sufst/tsal/hardware/hv_sense/hv_sense.kicad_pcb

## KiCad design hardware/hv_sense/hv_sense.kicad_pcb (2022-02-28)

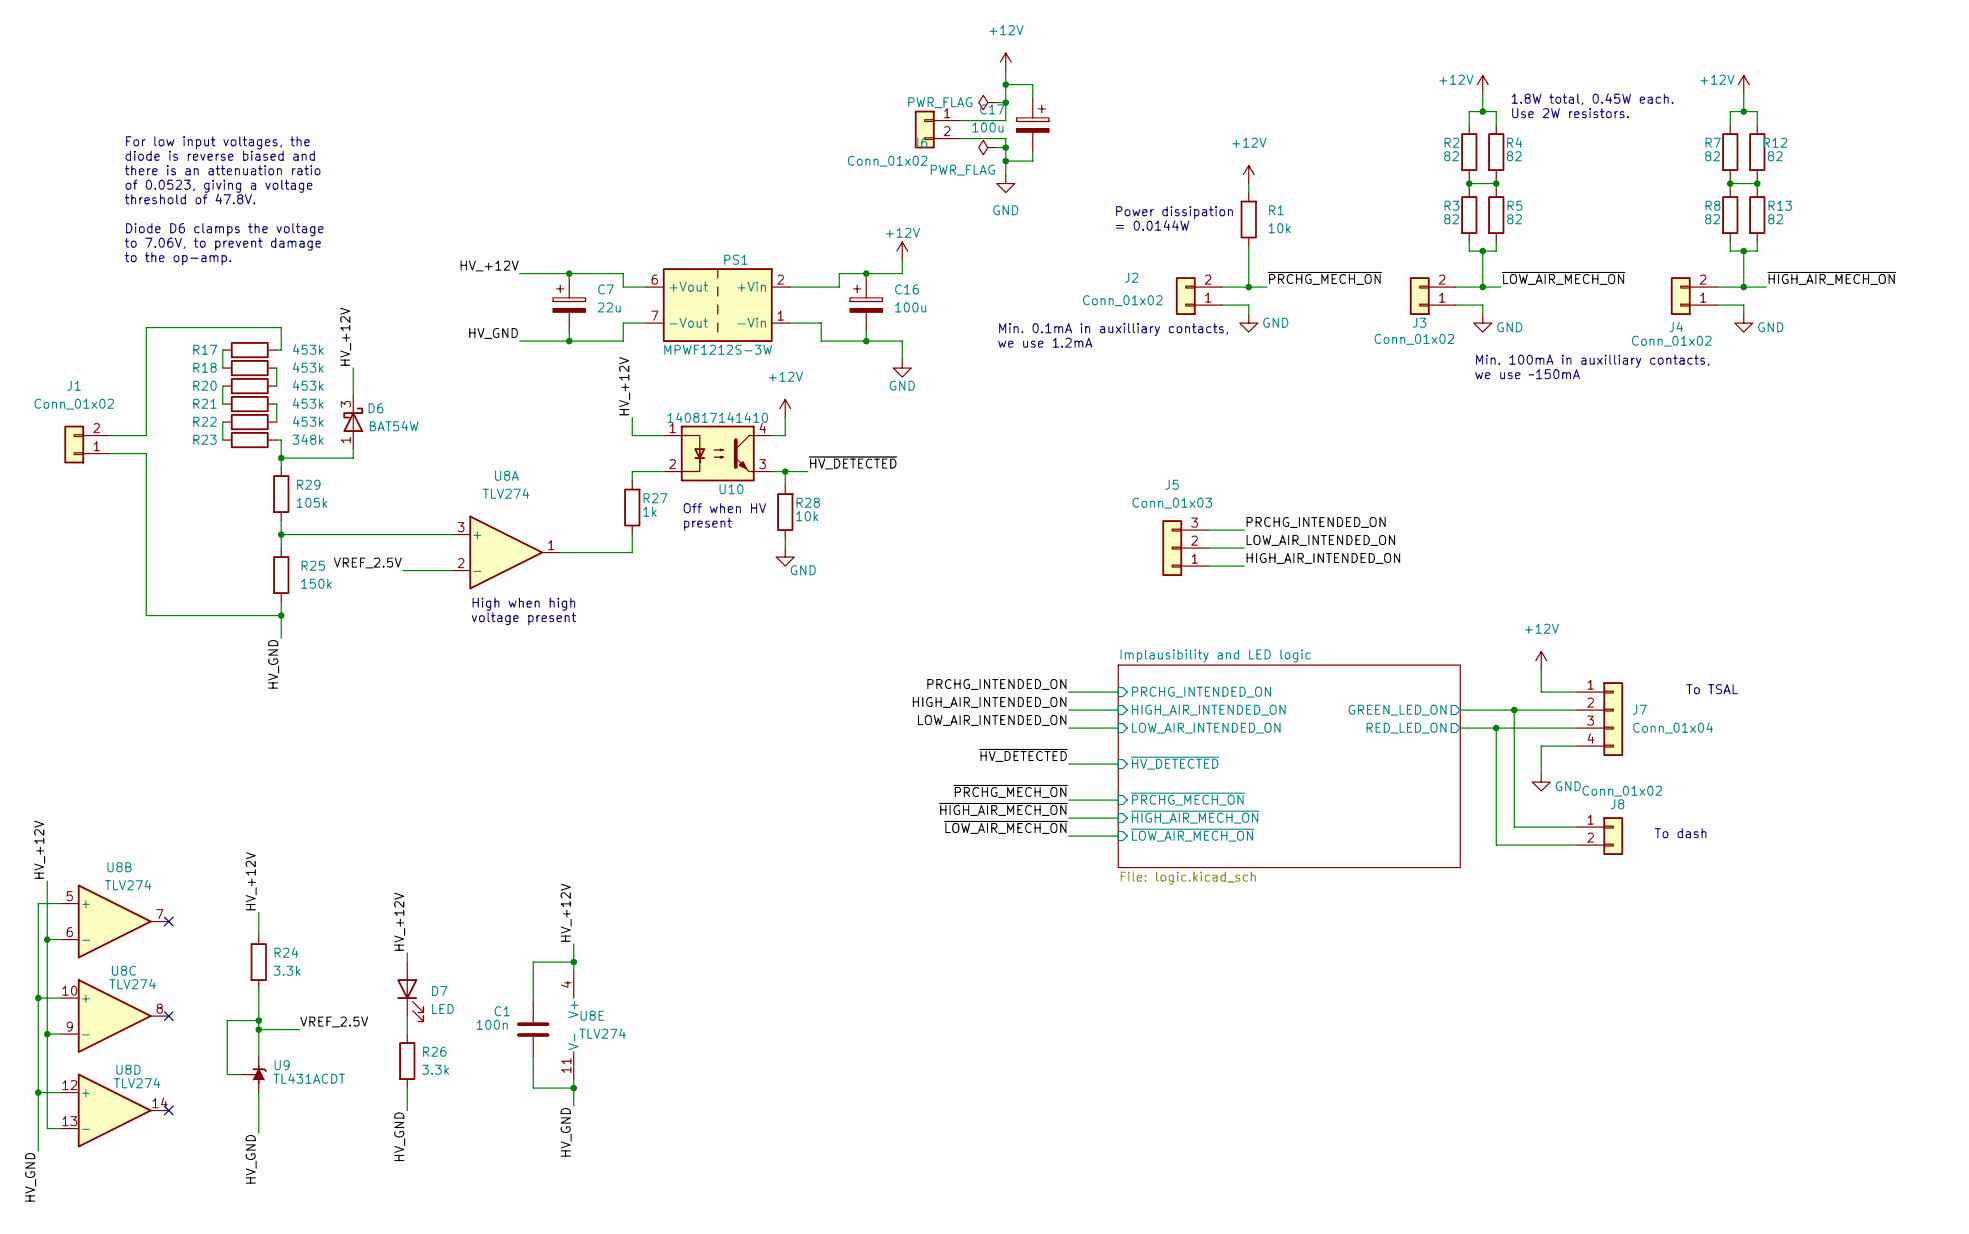
[picture p1: schematic hv_sense.kicad_sch]

Parts:
C1: 100n; C_0603_1608Metric
C7: 22u; CP_Radial_D8.0mm_P3.50mm
C16, C17: 100u; CP_Radial_D6.3mm_P2.50mm
D6: BAT54W; SOT-323_SC-70
D7: LED; LED_0603_1608Metric
J1, J2, J3, J4, J6, J8: Conn_01x02; Molex_Micro-Fit_3.0_43650-0200_1x02_P3.00mm_Horizontal
J5: Conn_01x03; Molex_Micro-Fit_3.0_43650-0300_1x03_P3.00mm_Horizontal
J7: Conn_01x04; Molex_Micro-Fit_3.0_43650-0400_1x04_P3.00mm_Horizontal
PS1: MPWF1212S-3W
R1, R28: 10k; R_0603_1608Metric
R2, R3, R4, R5, R7, R8, R12, R13: 82; R_2512_6332Metric
R17, R18, R20, R21, R22: 453k; R_0805_2012Metric
R23: 348k; R_0805_2012Metric
R24, R26: 3.3k; R_0603_1608Metric
R25: 150k; R_0603_1608Metric
R27: 1k; R_1206_3216Metric
R29: 105k; R_0805_2012Metric
U8: TLV274; SOIC-14_3.9x8.7mm_P1.27mm
U9: TL431ACDT; SOIC-8_3.9x4.9mm_P1.27mm
U10: 140817141410; DIP-4_W7.62mm

Connections:
+12V: C16.1, C17.1, J6.1, J7.1, PS1.2 (+Vin), R1.2, R2.1, R4.1, R7.1, R12.1, U10.4; also elsewhere on the board
/HIGH_AIR_INTENDED_ON: J5.1; also elsewhere on the board
/HV_+12V: C1.1, C7.1, D6.3 (K), D7.2 (A), PS1.6 (+Vout), R24.1, U8.4 (V+), U8.6 (-), U8.9 (-), U8.13 (-), U10.1
/HV_GND: C1.2, C7.2, J1.1, PS1.7 (-Vout), R25.2, R26.2, U8.5 (+), U8.10 (+), U8.11 (V-), U8.12 (+), U9.2 (A), U9.3 (A), U9.6 (A), U9.7 (A)
/Implausibility and LED logic/GREEN_LED_ON: J7.2, J8.1; also elsewhere on the board
/Implausibility and LED logic/RED_LED_ON: J7.3, J8.2; also elsewhere on the board
/LOW_AIR_INTENDED_ON: J5.2; also elsewhere on the board
/PRCHG_INTENDED_ON: J5.3; also elsewhere on the board
/VREF_2.5V: R24.2, U8.2 (-), U9.1 (K), U9.8 (REF)
/~HIGH_AIR_MECH_ON: J4.2, R8.2, R13.2; also elsewhere on the board
/~HV_DETECTED: R28.2, U10.3; also elsewhere on the board
/~LOW_AIR_MECH_ON: J3.2, R3.2, R5.2; also elsewhere on the board
/~PRCHG_MECH_ON: J2.2, R1.1; also elsewhere on the board
GND: C16.2, C17.2, J2.1, J3.1, J4.1, J6.2, J7.4, PS1.1 (-Vin), R28.1; also elsewhere on the board
unnamed: D6.1 (A), R23.1, R29.1
unnamed: D7.1 (K), R26.1
unnamed: J1.2, R17.1
unnamed: R2.2, R3.1, R4.2, R5.1
unnamed: R7.2, R8.1, R12.2, R13.1
unnamed: R17.2, R18.2
unnamed: R18.1, R20.1
unnamed: R20.2, R21.2
unnamed: R21.1, R22.1
unnamed: R22.2, R23.2
unnamed: R25.1, R29.2, U8.3 (+)
unnamed: R27.1, U8.1
unnamed: R27.2, U10.2

Notes on the sheet:
1.8W total, 0.45W each. Use 2W resistors.
Off when HV present
Power dissipation = 0.0144W
Min. 0.1mA in auxilliary contacts, we use 1.2mA
To TSAL
High when high voltage present
Min. 100mA in auxilliary contacts, we use ~150mA
For low input voltages, the diode is reverse biased and there is an attenuation ratio of 0.0523, giving a voltage threshold of 47.8V. Diode D6 clamps the voltage to 7.06V, to prevent damage to the op-amp.
To dash

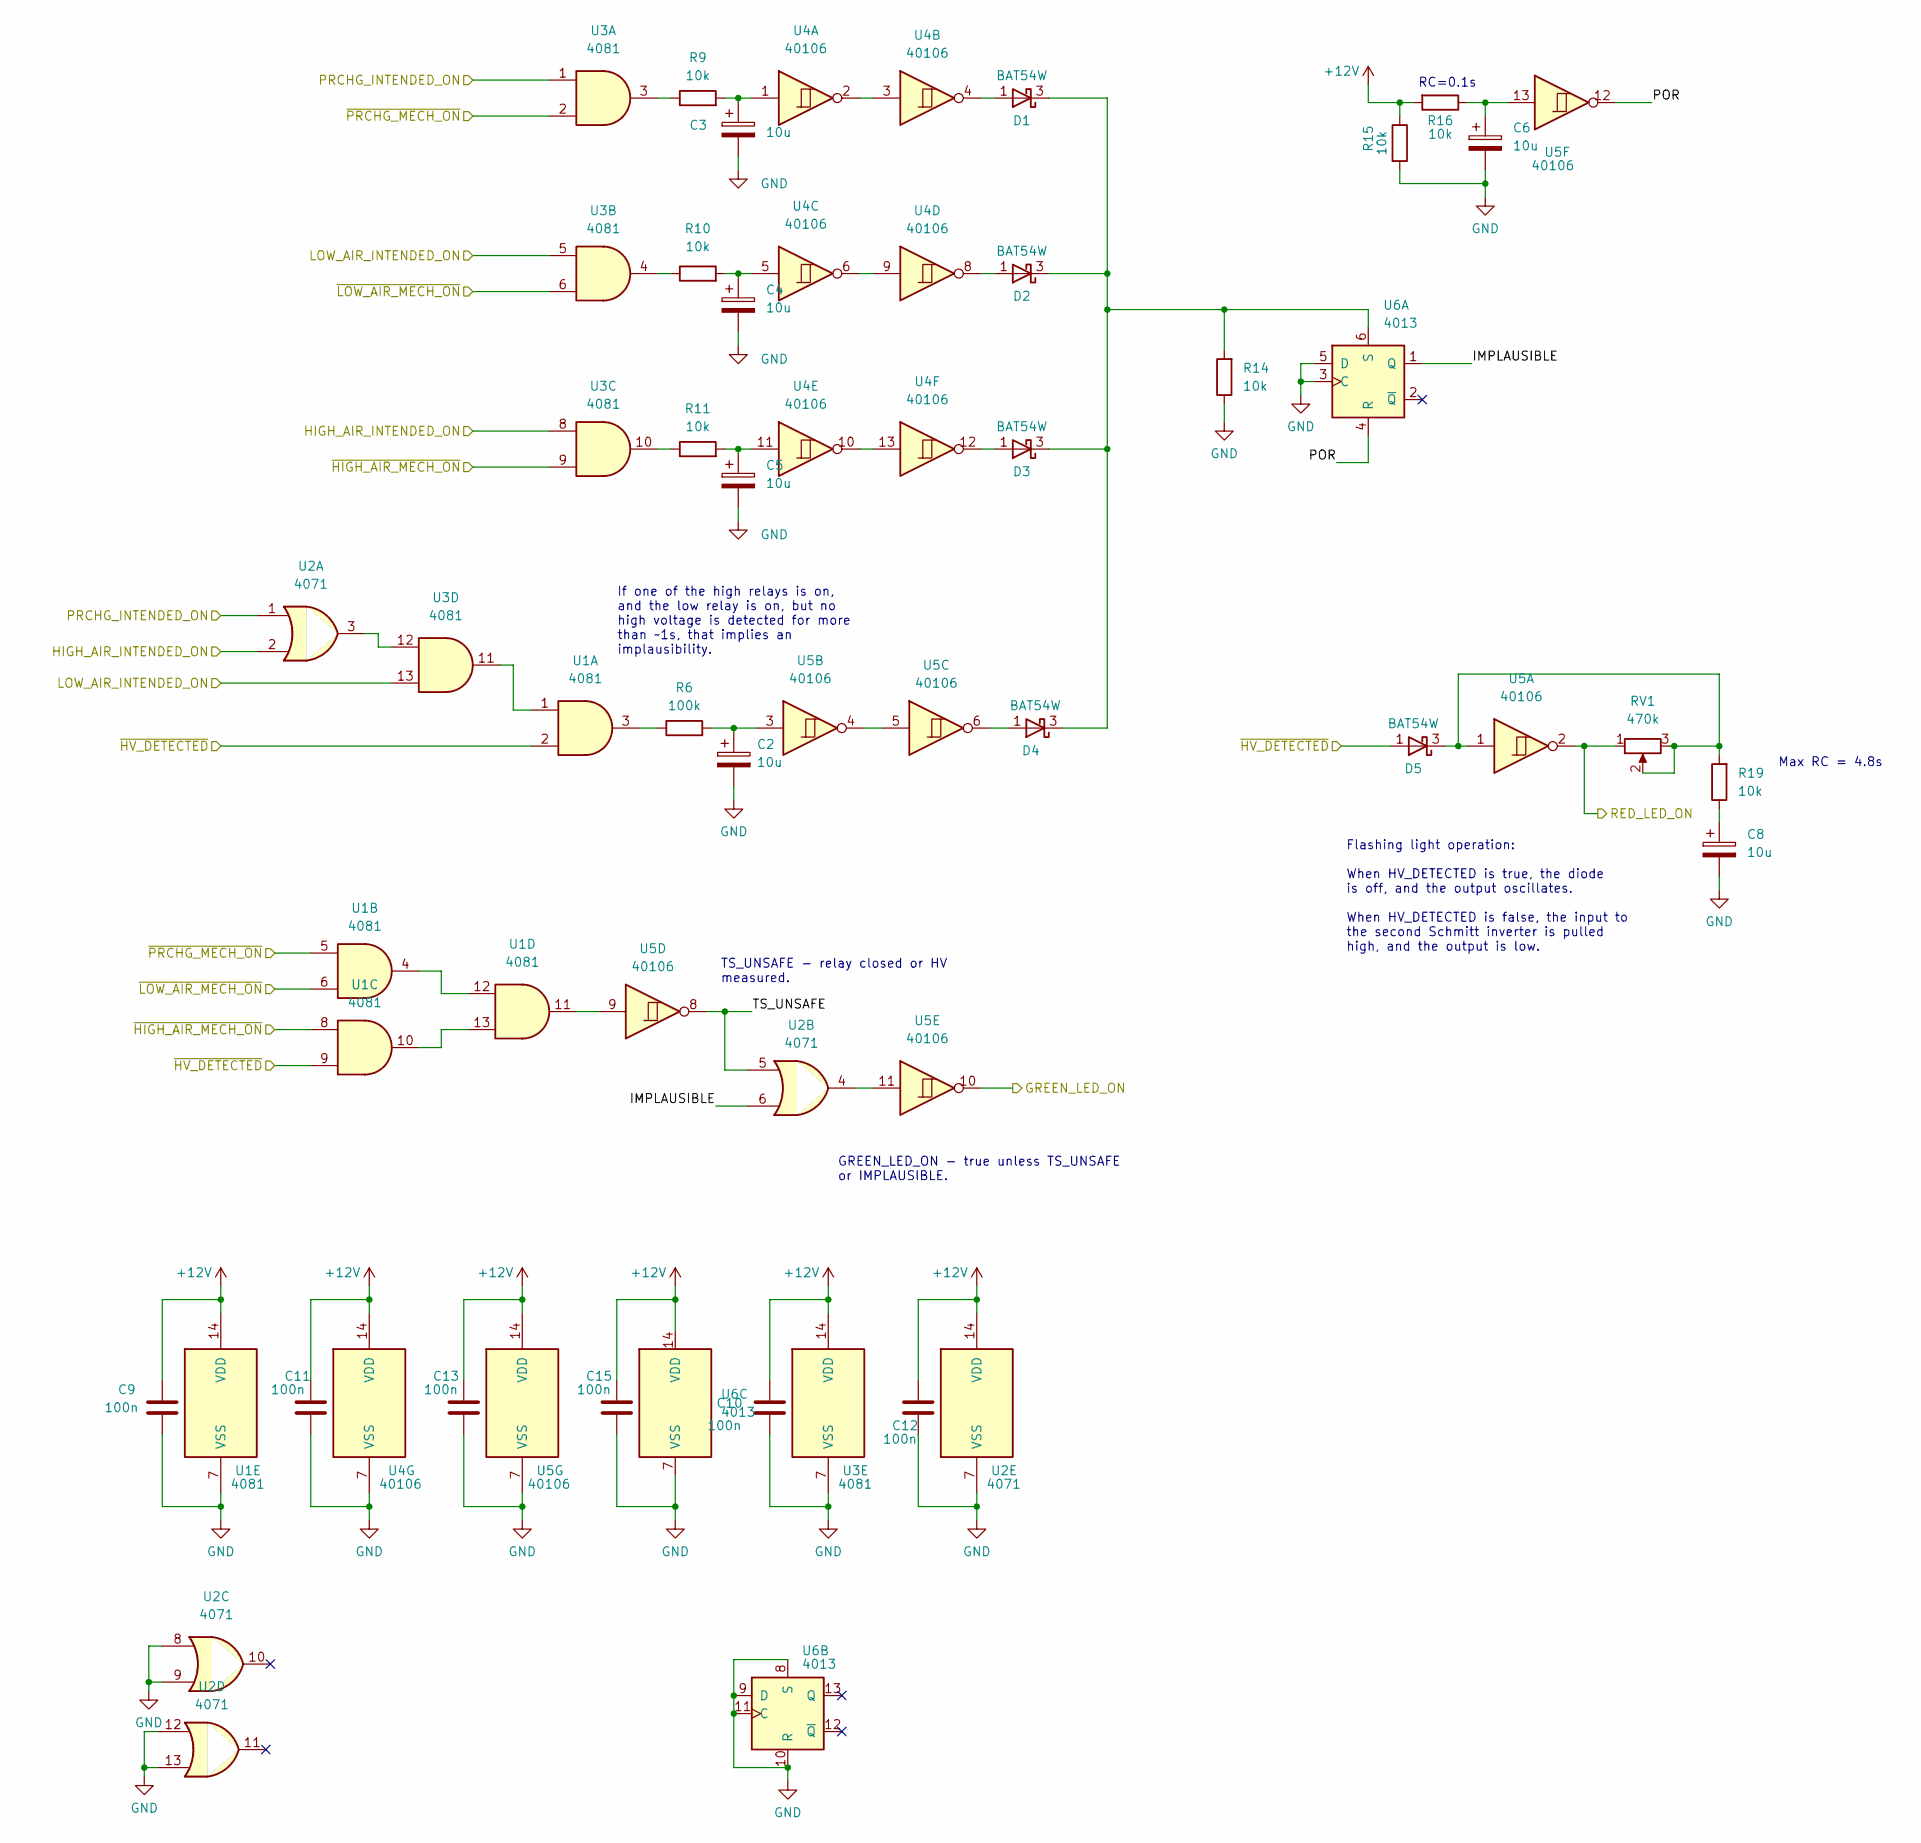
[picture p2: schematic logic.kicad_sch]

Parts:
C2, C3, C4, C5, C6, C8: 10u; CP_Radial_D5.0mm_P2.00mm
C9, C10, C11, C12, C13, C15: 100n; C_0603_1608Metric
D1, D2, D3, D4, D5: BAT54W; SOT-323_SC-70
R6: 100k; R_0603_1608Metric
R9, R10, R11, R14, R15, R16, R19: 10k; R_0603_1608Metric
RV1: 470k; Potentiometer_Bourns_3296W_Vertical
U1, U3: 4081; SOIC-14_3.9x8.7mm_P1.27mm
U2: 4071; SOIC-14_3.9x8.7mm_P1.27mm
U4, U5: 40106; SOIC-14_3.9x8.7mm_P1.27mm
U6: 4013; SOIC-14_3.9x8.7mm_P1.27mm

Connections:
+12V: C9.1, C10.1, C11.1, C12.1, C13.1, C15.1, R15.1, R16.2, U1.14 (VDD), U2.14 (VDD), U3.14 (VDD), U4.14 (VDD), U5.14 (VDD), U6.14 (VDD); also elsewhere on the board
/HIGH_AIR_INTENDED_ON: U2.2, U3.8; also elsewhere on the board
/Implausibility and LED logic/GREEN_LED_ON: U5.10; also elsewhere on the board
/Implausibility and LED logic/IMPLAUSIBLE: U2.6, U6.1 (Q)
/Implausibility and LED logic/POR: U5.12, U6.4 (R)
/Implausibility and LED logic/RED_LED_ON: RV1.1, U5.2; also elsewhere on the board
/Implausibility and LED logic/TS_UNSAFE: U2.5, U5.8
/LOW_AIR_INTENDED_ON: U3.5, U3.13; also elsewhere on the board
/PRCHG_INTENDED_ON: U2.1, U3.1; also elsewhere on the board
/~HIGH_AIR_MECH_ON: U1.8, U3.9; also elsewhere on the board
/~HV_DETECTED: D5.1 (A), U1.2, U1.9; also elsewhere on the board
/~LOW_AIR_MECH_ON: U1.6, U3.6; also elsewhere on the board
/~PRCHG_MECH_ON: U1.5, U3.2; also elsewhere on the board
GND: C2.2, C3.2, C4.2, C5.2, C6.2, C8.2, C9.2, C10.2, C11.2, C12.2, C13.2, C15.2, R14.1, R15.2, U1.7 (VSS), U2.7 (VSS), U2.8, U2.9, U2.12, U2.13, U3.7 (VSS), U4.7 (VSS), U5.7 (VSS), U6.3 (C), U6.5 (D), U6.7 (VSS), U6.8 (S), U6.9 (D), U6.10 (R), U6.11 (C); also elsewhere on the board
unnamed: C2.1, R6.2, U5.3
unnamed: C3.1, R9.2, U4.1
unnamed: C4.1, R10.2, U4.5
unnamed: C5.1, R11.2, U4.11
unnamed: C6.1, R16.1, U5.13
unnamed: C8.1, R19.1
unnamed: D1.1 (A), U4.4
unnamed: D1.3 (K), D2.3 (K), D3.3 (K), D4.3 (K), R14.2, U6.6 (S)
unnamed: D2.1 (A), U4.8
unnamed: D3.1 (A), U4.12
unnamed: D4.1 (A), U5.6
unnamed: D5.3 (K), R19.2, RV1.2, RV1.3, U5.1
unnamed: R6.1, U1.3
unnamed: R9.1, U3.3
unnamed: R10.1, U3.4
unnamed: R11.1, U3.10
unnamed: U1.1, U3.11
unnamed: U1.10, U1.13
unnamed: U1.11, U5.9
unnamed: U1.4, U1.12
unnamed: U2.3, U3.12
unnamed: U2.4, U5.11
unnamed: U4.2, U4.3
unnamed: U4.6, U4.9
unnamed: U4.10, U4.13
unnamed: U5.4, U5.5

Notes on the sheet:
Flashing light operation: When HV_DETECTED is true, the diode is off, and the output oscillates. When HV_DETECTED is false, the input to the second Schmitt inverter is pulled high, and the output is low.
Max RC = 4.8s
GREEN_LED_ON - true unless TS_UNSAFE or IMPLAUSIBLE.
If one of the high relays is on, and the low relay is on, but no high voltage is detected for more than ~1s, that implies an implausibility.
RC=0.1s
TS_UNSAFE - relay closed or HV measured.

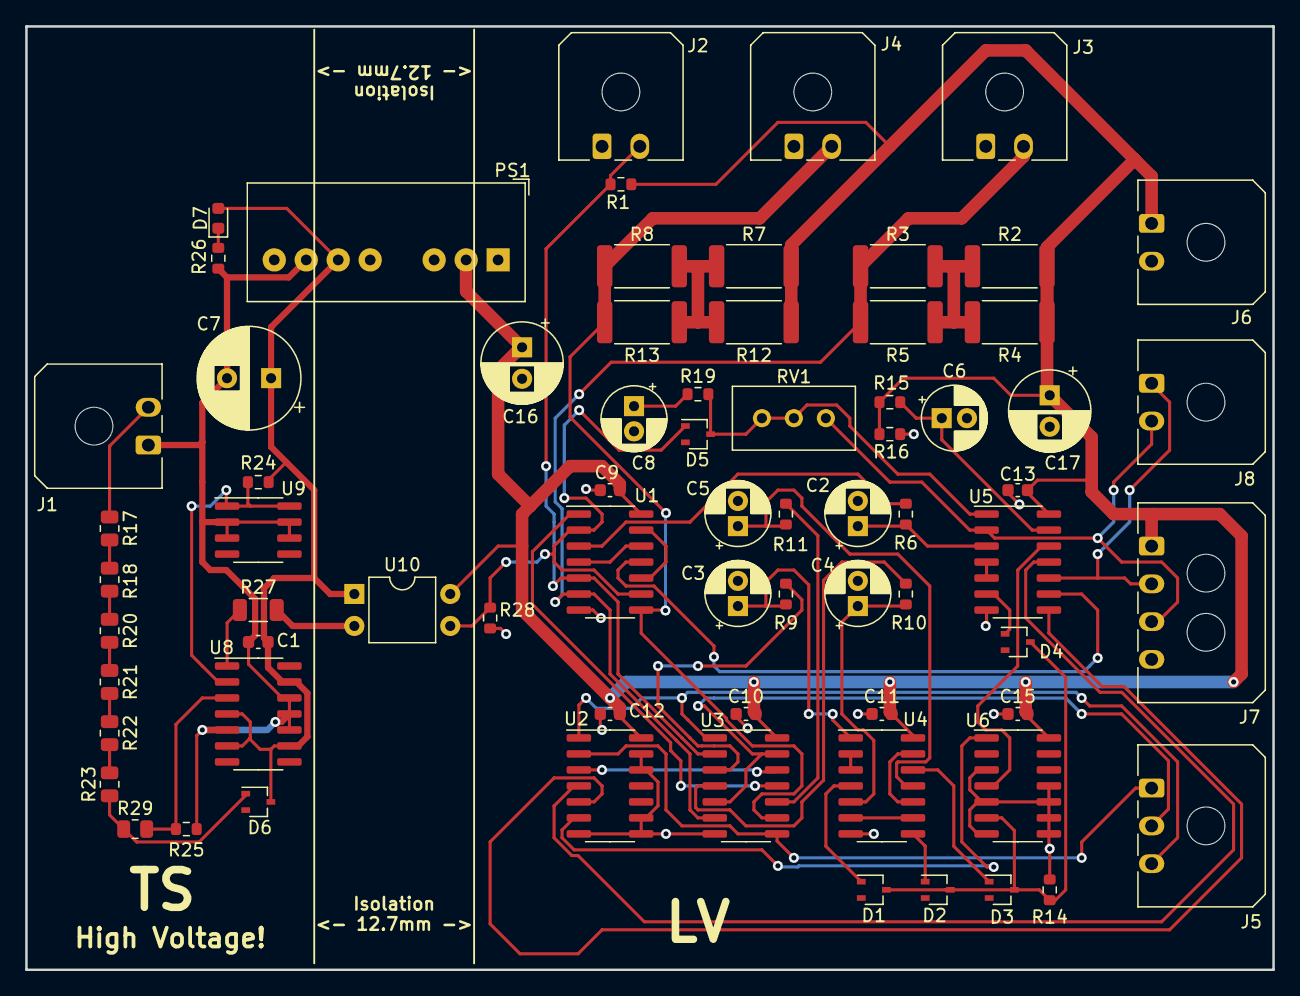
[picture p3: board hv_sense.kicad_pcb from above]

Board: 2 copper layers, 99.1 x 74.9 mm, 71 parts (0 on the bottom side), 56 nets.
