sufst/tsal/hardware/tsal/tsal.kicad_pcb

## KiCad design hardware/tsal/tsal.kicad_pcb (2022-02-18)

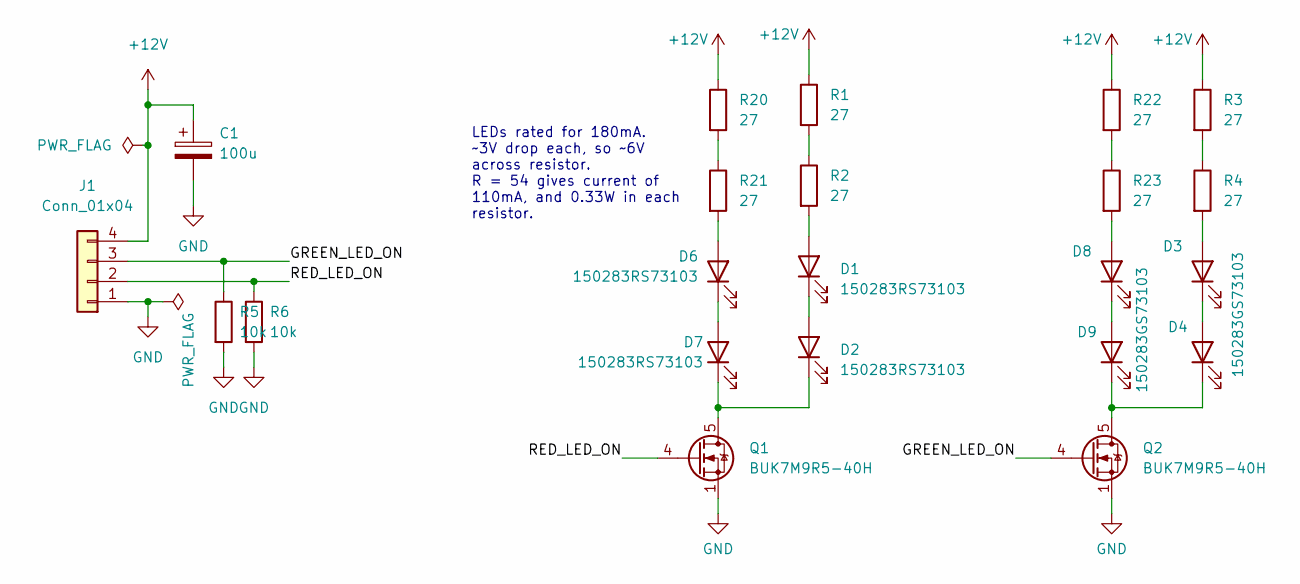
[picture p4: schematic tsal.kicad_sch]

Parts:
C1: 100u; CP_Radial_D6.3mm_P2.50mm
D1, D2, D6, D7: 150283RS73103; Wurth_WL-SMTW
D3, D4, D8, D9: 150283GS73103; Wurth_WL-SMTW
J1: Conn_01x04; Molex_Micro-Fit_3.0_43650-0400_1x04_P3.00mm_Horizontal
Q1, Q2: BUK7M9R5-40H; LFPAK33
R1, R2, R3, R4, R20, R21, R22, R23: 27; R_2512_6332Metric
R5, R6: 10k; R_0603_1608Metric

Connections:
+12V: C1.1, J1.4, R1.1, R3.1, R20.1, R22.1
/GREEN_LED_ON: J1.3, Q2.4 (G), R5.1
/RED_LED_ON: J1.2, Q1.4 (G), R6.1
GND: C1.2, J1.1, Q1.1 (S), Q1.2 (S), Q1.3 (S), Q2.1 (S), Q2.2 (S), Q2.3 (S), R5.2, R6.2
unnamed: D1.1 (K), D2.2 (A)
unnamed: D1.2 (A), R2.2
unnamed: D3.1 (K), D4.2 (A)
unnamed: D3.2 (A), R4.2
unnamed: D6.1 (K), D7.2 (A)
unnamed: D6.2 (A), R21.2
unnamed: D2.1 (K), D7.1 (K), Q1.5 (D)
unnamed: D8.1 (K), D9.2 (A)
unnamed: D8.2 (A), R23.2
unnamed: D4.1 (K), D9.1 (K), Q2.5 (D)
unnamed: R1.2, R2.1
unnamed: R3.2, R4.1
unnamed: R20.2, R21.1
unnamed: R22.2, R23.1

Notes on the sheet:
LEDs rated for 180mA. ~3V drop each, so ~6V across resistor. R = 54 gives current of 110mA, and 0.33W in each resistor.

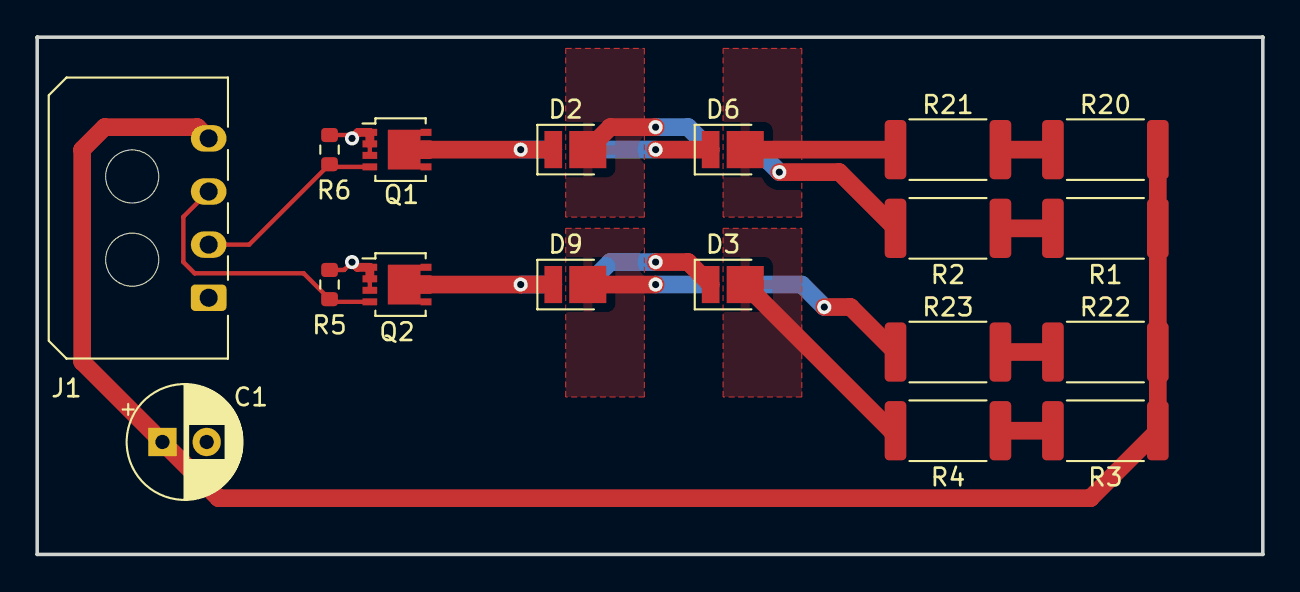
[picture p5: board tsal.kicad_pcb from above]

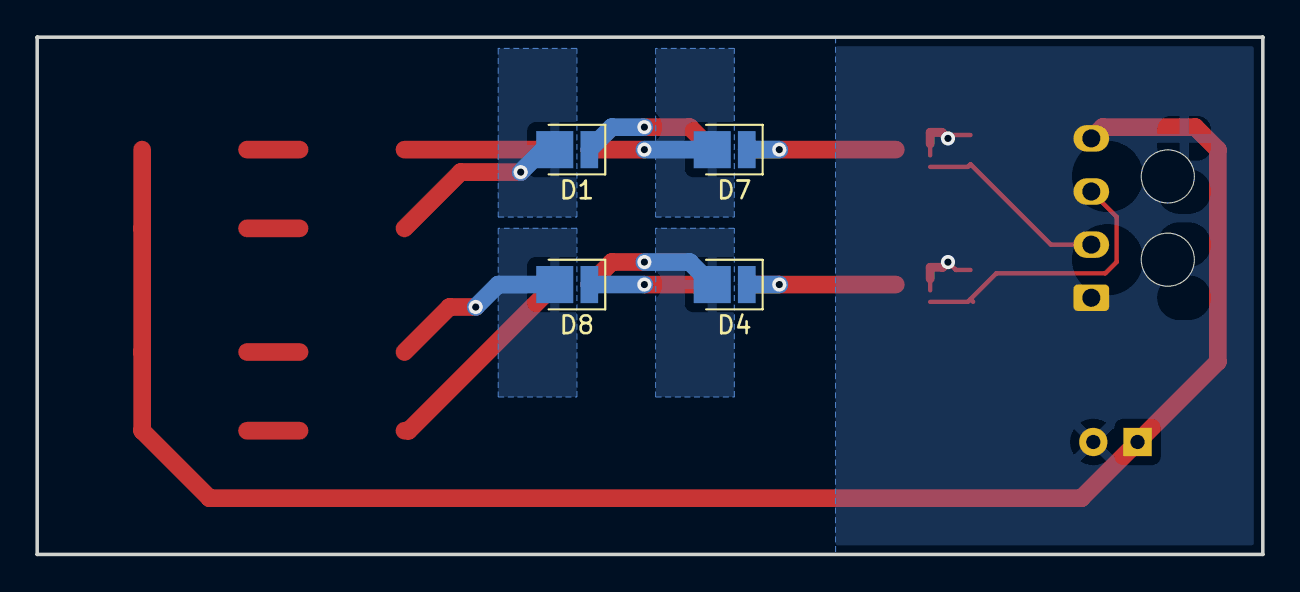
[picture p6: board tsal.kicad_pcb from below]

Board: 2 copper layers, 69.2 x 29.2 mm, 22 parts (4 on the bottom side), 18 nets.
