sufst/tsal/(commit log)

2022-02-17 Made some progress on the PCB
    [tsal.kicad_pcb, tsal.kicad_sch]
2022-02-17 Integrated TSAL logic into hv_sense
    [hv_sense.kicad_pcb, hv_sense.kicad_sch, logic.kicad_sch]
2022-02-17 Begun routing hv_sense
    [hv_sense.kicad_pcb]
2022-02-18 Routed LV side of hv_sense
    [hv_sense.kicad_pcb]
2022-02-18 Routing done, still needs finishing touches though
    [hv_sense.kicad_pcb, hv_sense.kicad_sch]
2022-02-18 Designed and finished layout of TSAL
    [tsal.kicad_pcb, tsal.kicad_sch]
2022-02-18 Added edge, moved component references to be visible
    [hv_sense.kicad_pcb, hv_sense.kicad_sch]
2022-02-18 Added mounting holes and TS/LV labels
    [hv_sense.kicad_pcb]
2022-02-18 Fixed references
    [tsal.kicad_pcb]
2022-02-28 Capped voltage input to opamp
    [hv_sense.kicad_pcb, hv_sense.kicad_sch]
2022-04-30 Added switch to choose between FSG and FSUK rules
    [hv_sense.kicad_sch, logic.kicad_sch]
